arghfu/kicad-libs/3d_packages/con_fpc_20.stp

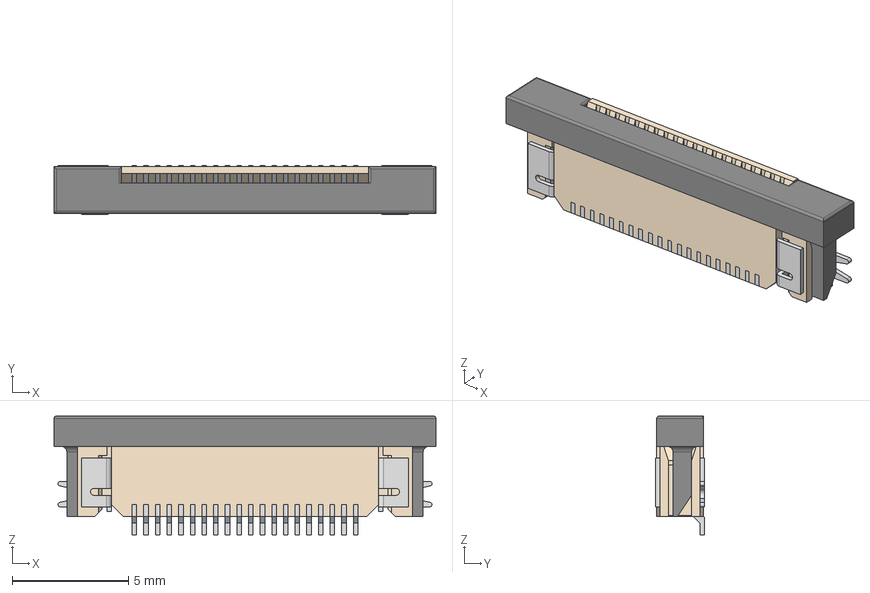
[picture p2: CAD file, 2024-05-11]
3d_packages/con_fpc_20.stp
16.4 x 2.10 x 5.10 mm
6871xx14522_PIN x 20
6871xx14522_Patte
6871xx14522_Patte_2
68712014522_CAP
