arghfu/kicad-libs/3d_packages/SW_PTS820J25MSMTRLFS.stp

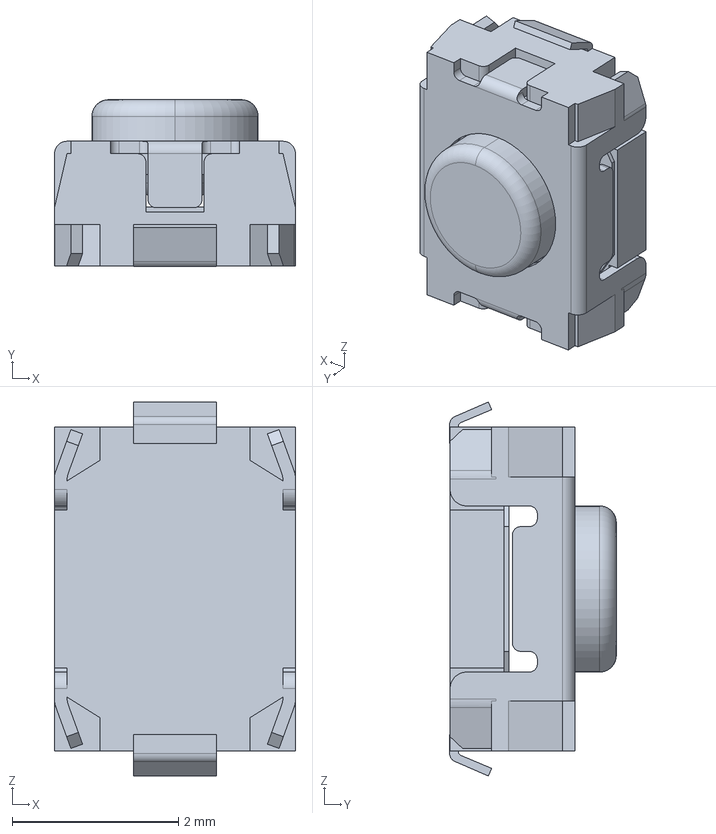
[picture p3: CAD file, 2024-05-11]
3d_packages/SW_PTS820J25MSMTRLFS.stp
2.90 x 2.00 x 4.50 mm
