arghfu/kicad-libs/3d_packages/TSM-104-01-L-DH.step

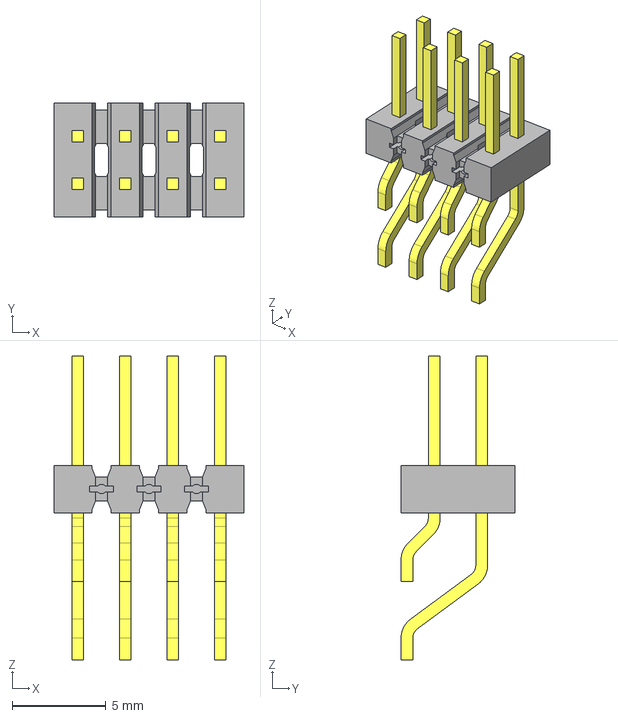
[picture p4: CAD file, 2024-05-11]
3d_packages/TSM-104-01-L-DH.step
10.2 x 6.10 x 16.3 mm
T-1S6-09(-01-4-DH)
TSM-104-01-DH_body
