arghfu/kicad-libs/3d_packages/SMI-1027-T-5V-R.step

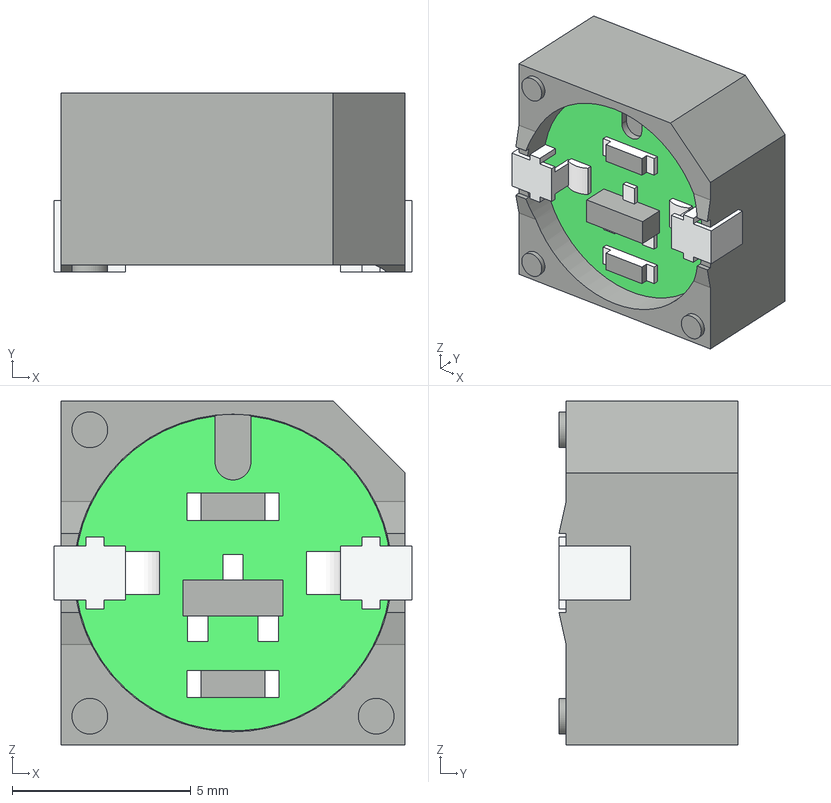
[picture p5: CAD file, 2024-05-11]
3d_packages/SMI-1027-T-5V-R.step
10.0 x 5.00 x 9.60 mm
