arghfu/kicad-libs/3d_packages/User Library-3020-20-0300-xx.STEP

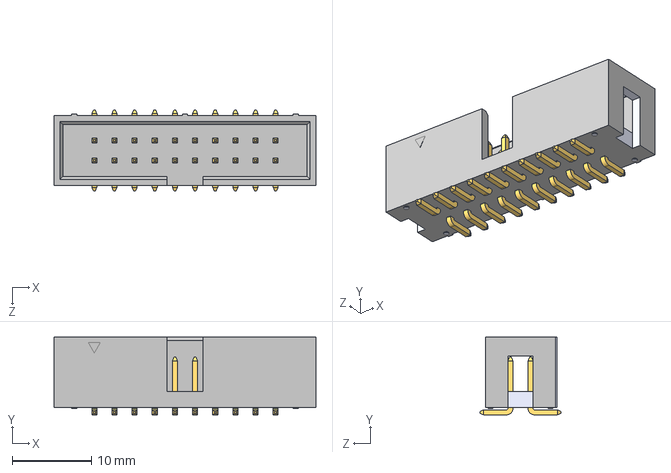
[picture p6: CAD file, 2024-05-11]
3d_packages/User Library-3020-20-0300-xx.STEP
33.0 x 9.80 x 10.2 mm
00-H
00-T-SMT
