arghfu/kicad-libs/3d_packages/NRS8040T.step

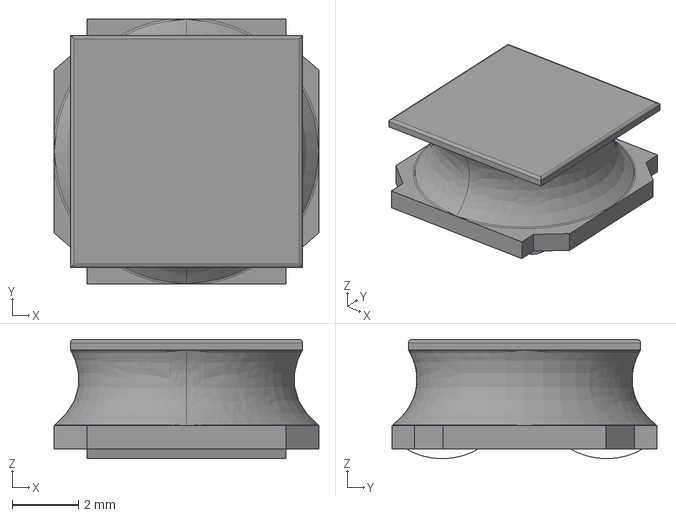
[picture p7: CAD file, 2024-05-11]
3d_packages/NRS8040T.step
8.00 x 8.00 x 3.60 mm
