arghfu/kicad-libs/3d_packages/NR4018T221M.stp

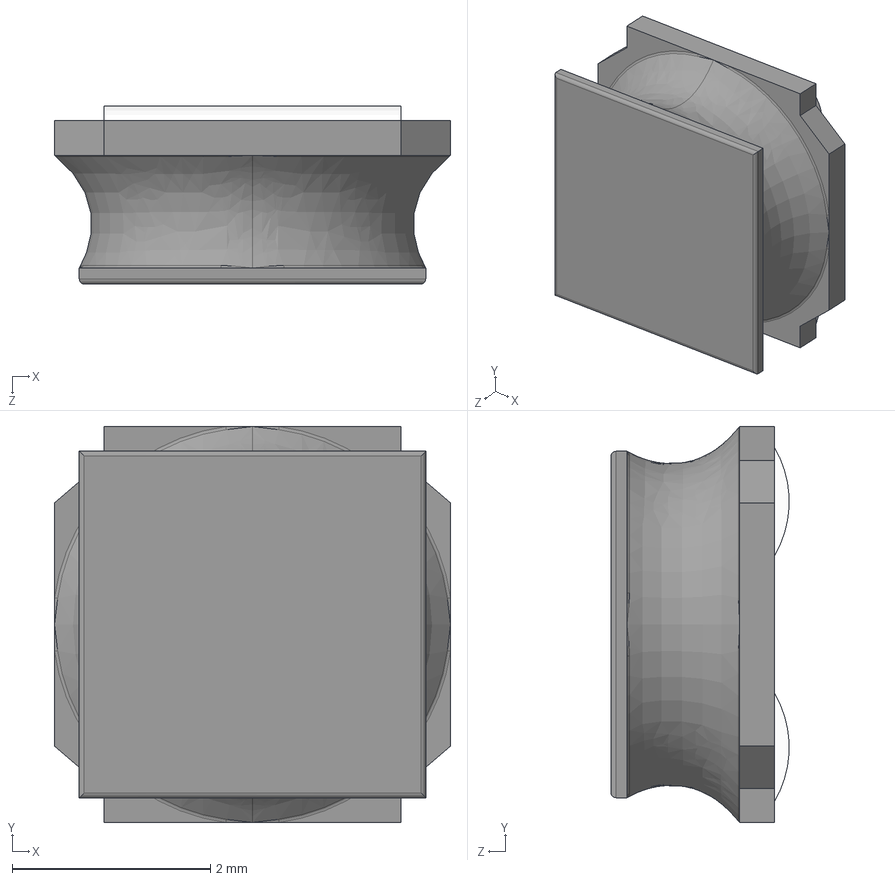
[picture p8: CAD file, 2024-05-11]
3d_packages/NR4018T221M.stp
4.00 x 4.00 x 1.80 mm
