arghfu/kicad-libs/3d_packages/PowerPAK 1212-8.STEP

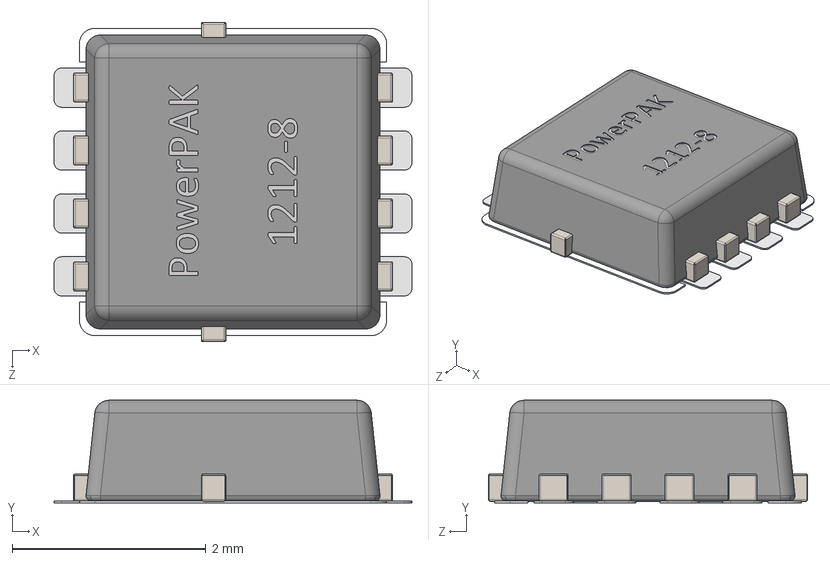
[picture p9: CAD file, 2024-05-11]
3d_packages/PowerPAK 1212-8.STEP
3.70 x 1.06 x 3.30 mm
