arghfu/kicad-libs/3d_packages/con_fpc_6.stp

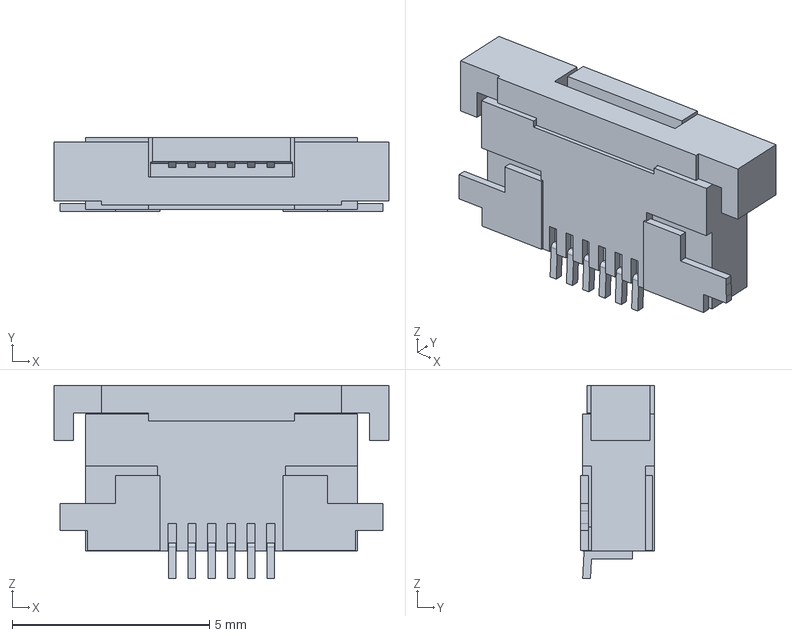
[picture p10: CAD file, 2024-05-11]
3d_packages/con_fpc_6.stp
8.50 x 1.87 x 4.90 mm
