arghfu/kicad-libs/3d_packages/flat_connector.stp

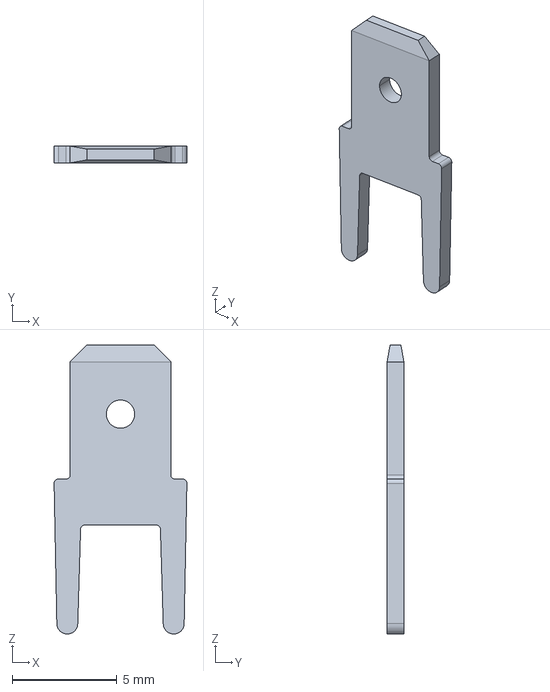
[picture p11: CAD file, 2024-05-11]
3d_packages/flat_connector.stp
6.34 x 0.8 x 13.8 mm
