arghfu/kicad-libs/3d_packages/CONMHF1-SMD-G-T.STEP

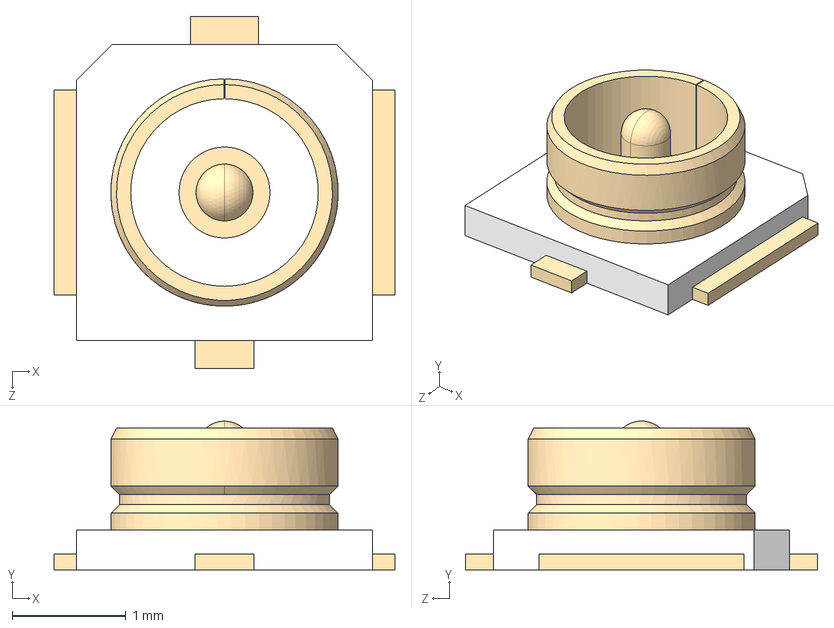
[picture p12: CAD file, 2024-05-11]
3d_packages/CONMHF1-SMD-G-T.STEP
3.00 x 1.31 x 3.10 mm
