arghfu/kicad-libs/3d_packages/Molex_Micro-Fit_3.0_43650-0715_1x07_P3.00mm_Vertical.stp

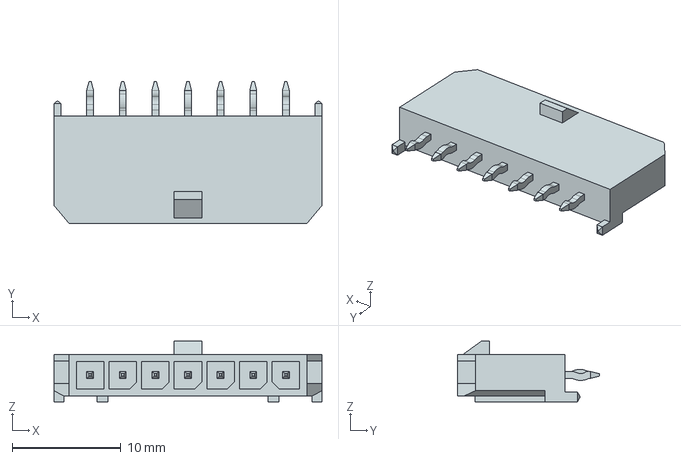
[picture p13: CAD file, 2024-05-11]
3d_packages/Molex_Micro-Fit_3.0_43650-0715_1x07_P3.00mm_Vertical.stp
24.6 x 13.1 x 5.57 mm
