arghfu/kicad-libs/3d_packages/con_fpc_31.stp

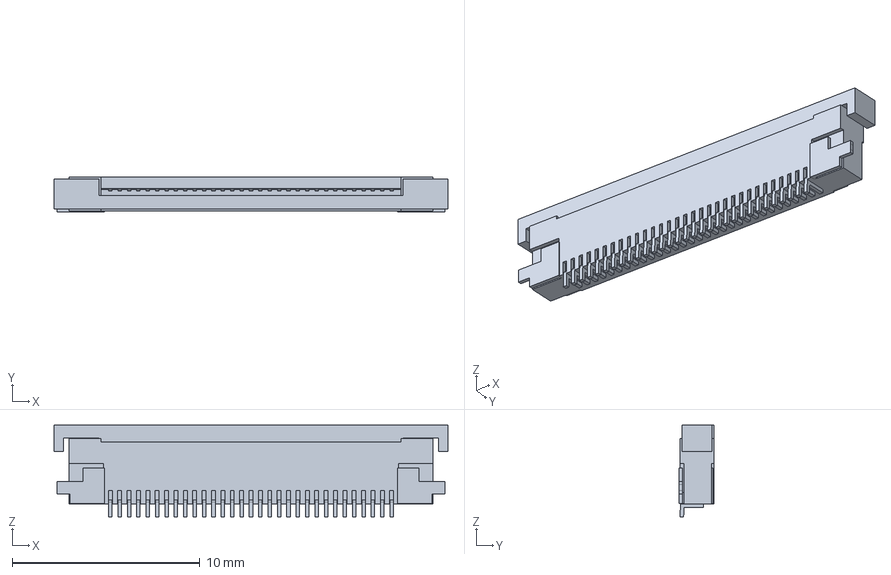
[picture p14: CAD file, 2024-05-11]
3d_packages/con_fpc_31.stp
21.0 x 1.87 x 4.90 mm
