arghfu/kicad-libs/3d_packages/WSL3637.STEP

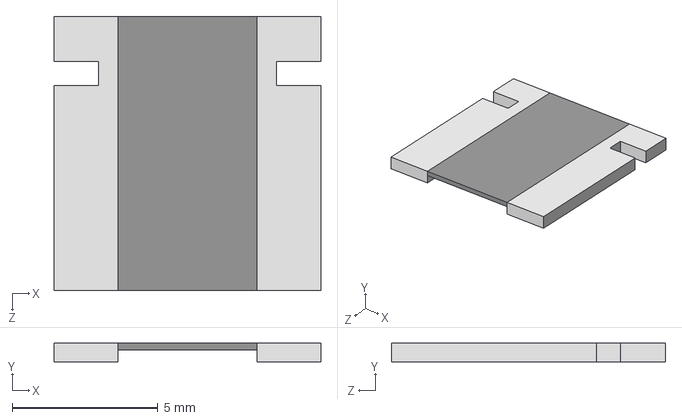
[picture p15: CAD file, 2024-05-11]
3d_packages/WSL3637.STEP
9.14 x 0.635 x 9.40 mm
