arghfu/kicad-libs/3d_packages/TestPoint_5015.STEP

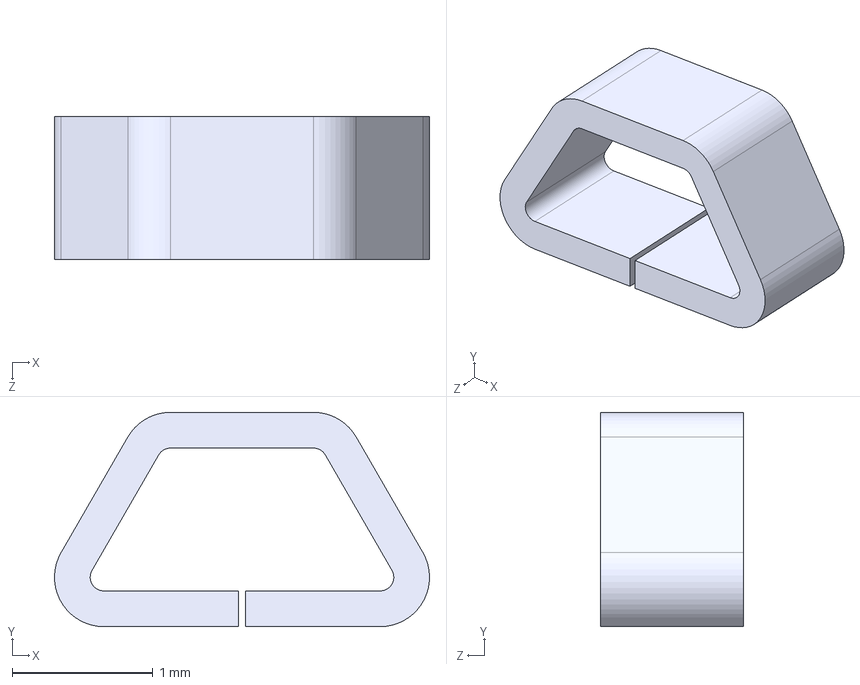
[picture p16: CAD file, 2024-05-11]
3d_packages/TestPoint_5015.STEP
2.67 x 1.52 x 1.02 mm
