arghfu/kicad-libs/3d_packages/con_usb_c_usb2-0.stp

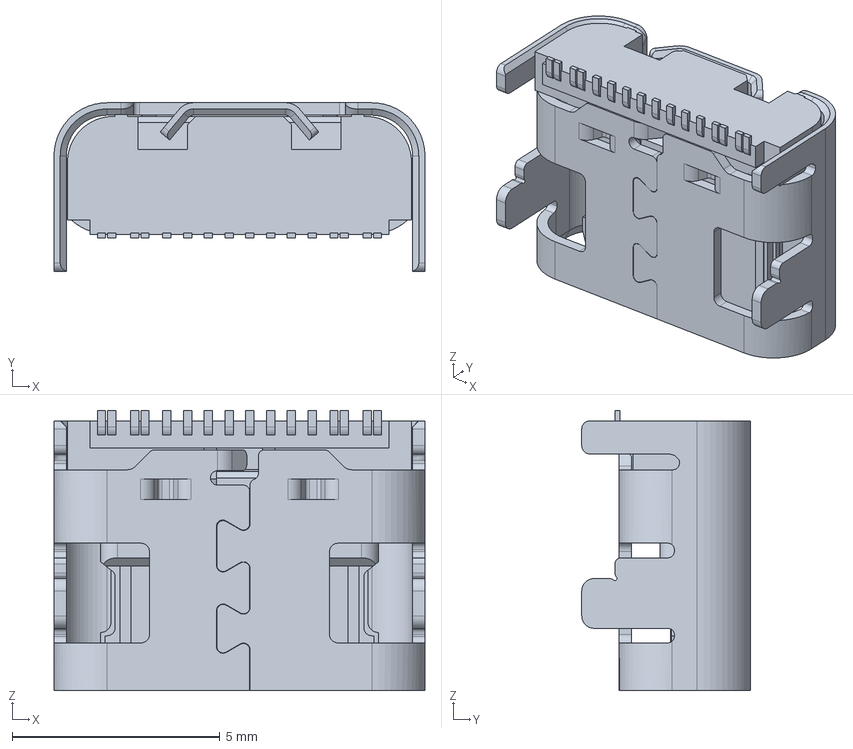
[picture p17: CAD file, 2024-05-11]
3d_packages/con_usb_c_usb2-0.stp
8.94 x 4.06 x 6.75 mm
