arghfu/kicad-libs/3d_packages/con_fpc_40.stp

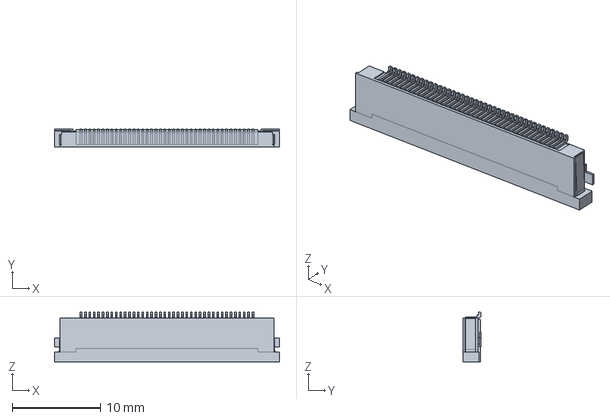
[picture p18: CAD file, 2024-05-11]
3d_packages/con_fpc_40.stp
25.5 x 2.06 x 5.64 mm
