arghfu/kicad-libs/3d_packages/NT2016SA.STEP

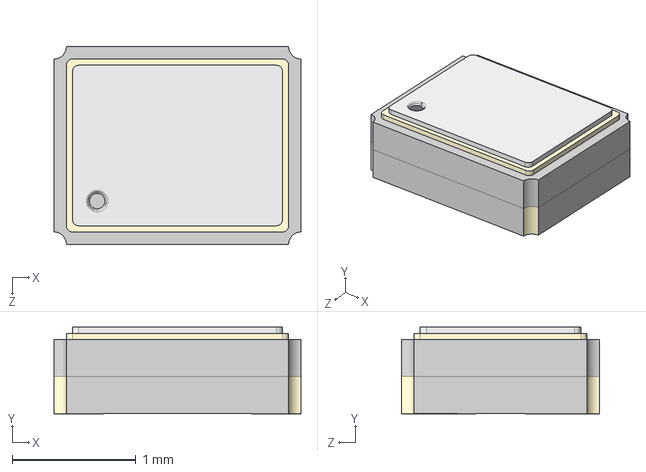
[picture p19: CAD file, 2024-05-11]
3d_packages/NT2016SA.STEP
2.00 x 0.701 x 1.60 mm
