arghfu/kicad-libs/3d_packages/TSM-106-01-L-DH.step

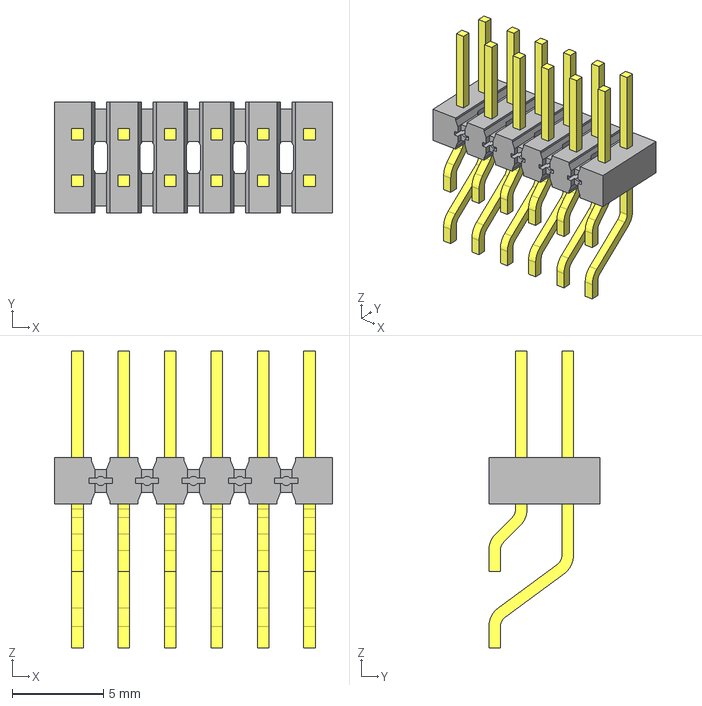
[picture p20: CAD file, 2024-05-11]
3d_packages/TSM-106-01-L-DH.step
15.2 x 6.10 x 16.3 mm
T-1S6-09(-01-6-DH)
TSM-106-01-DH_body
