arghfu/kicad-libs/3d_packages/con_2_10_1_27.igs

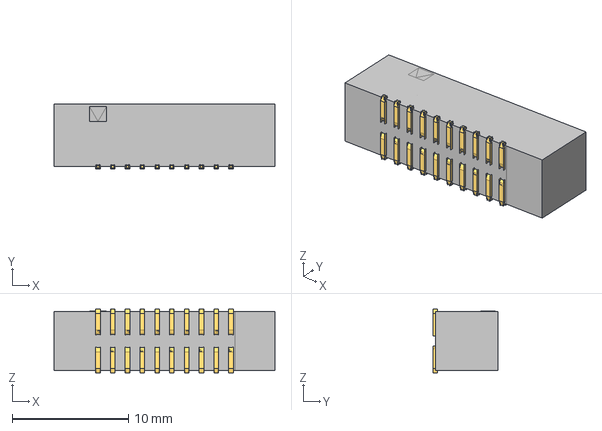
[picture p21: CAD file, 2024-05-11]
3d_packages/con_2_10_1_27.igs
19.0 x 5.60 x 5.50 mm
