arghfu/kicad-libs/3d_packages/CUI_DEVICES_MJ-2523.step

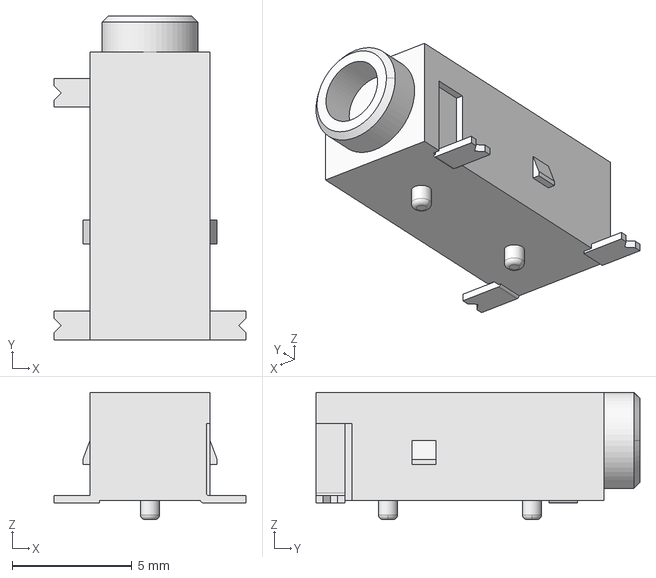
[picture p22: CAD file, 2024-05-11]
3d_packages/CUI_DEVICES_MJ-2523.step
8.00 x 13.5 x 5.30 mm
