arghfu/kicad-libs/3d_packages/SOP-4V2.STEP

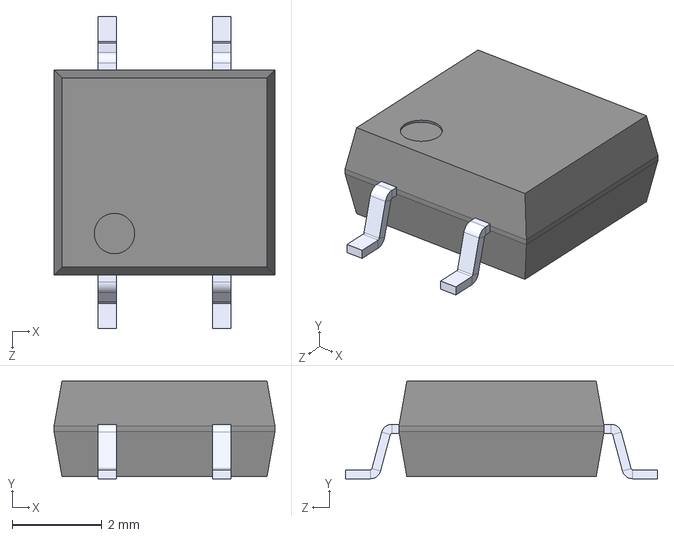
[picture p23: CAD file, 2024-05-11]
3d_packages/SOP-4V2.STEP
4.92 x 2.17 x 6.95 mm
