arghfu/kicad-libs/3d_packages/L_3012hbx.step

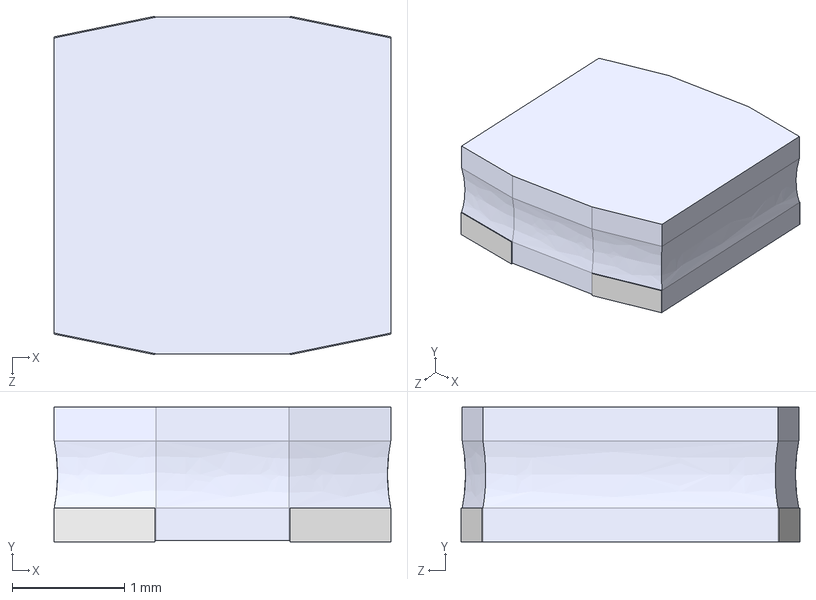
[picture p24: CAD file, 2024-05-11]
3d_packages/L_3012hbx.step
3.00 x 1.20 x 3.02 mm
