arghfu/kicad-libs/3d_packages/SW_SKRKAEE020.stp

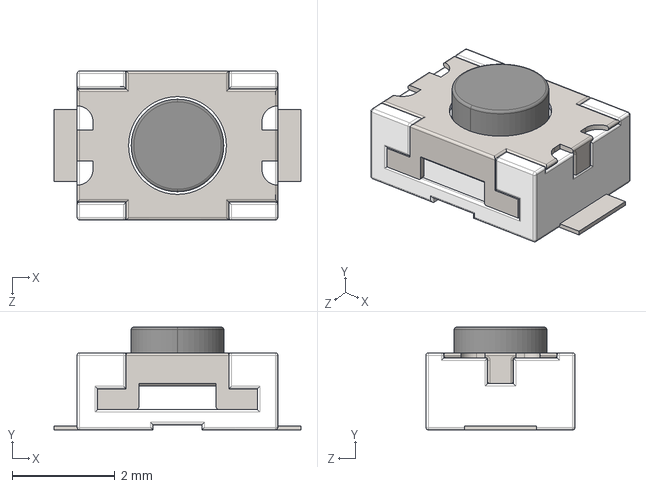
[picture p25: CAD file, 2024-05-11]
3d_packages/SW_SKRKAEE020.stp
4.80 x 2.00 x 2.90 mm
