arghfu/kicad-libs/3d_packages/BL654.STEP

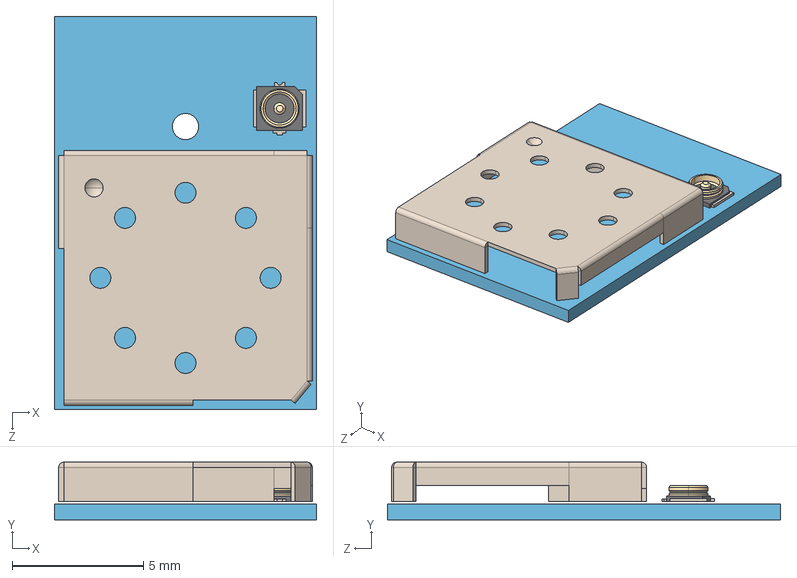
[picture p26: CAD file, 2024-05-11]
3d_packages/BL654.STEP
10.0 x 2.20 x 15.0 mm
BL654 PCB
bl654_shielding_can_20180124
BL654 Solder Pad x 72
BL652 A1 MHF4 Connector
