arghfu/kicad-libs/3d_packages/TSM-105-01-L-DH.step

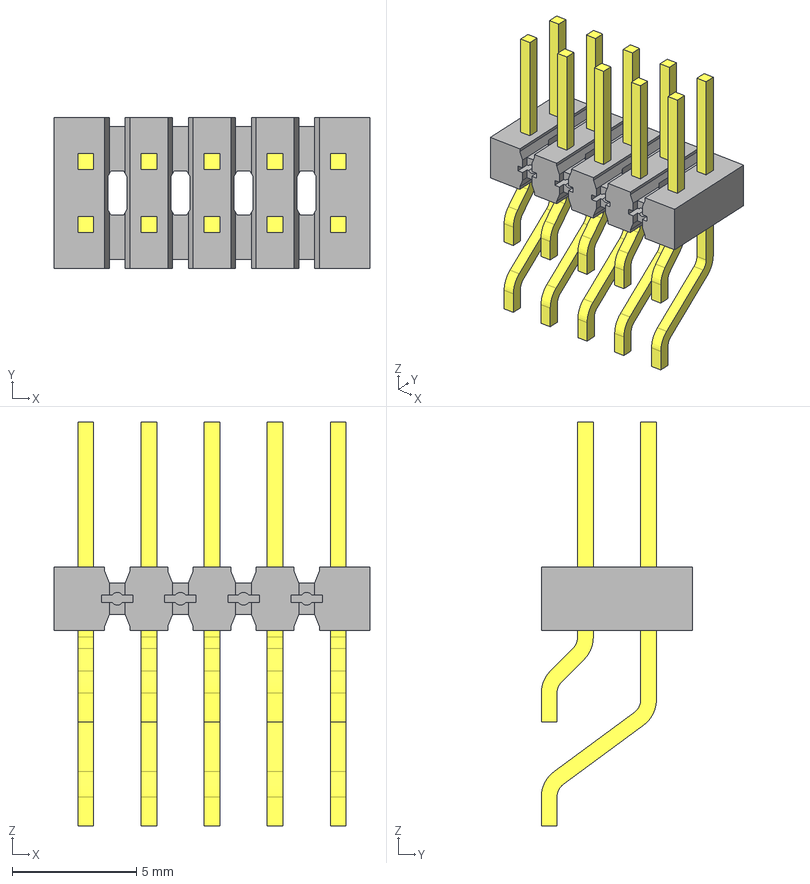
[picture p27: CAD file, 2024-05-11]
3d_packages/TSM-105-01-L-DH.step
12.7 x 6.10 x 16.3 mm
T-1S6-09(-01-5-DH)
TSM-105-01-DH_body
