arghfu/kicad-libs/3d_packages/sw_B3S.STEP

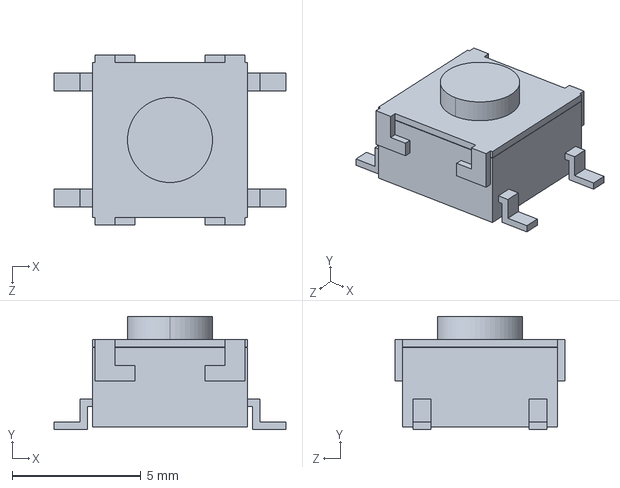
[picture p28: CAD file, 2024-05-11]
3d_packages/sw_B3S.STEP
9.00 x 4.40 x 6.60 mm
