arghfu/kicad-libs/3d_packages/con_fpc_5.stp

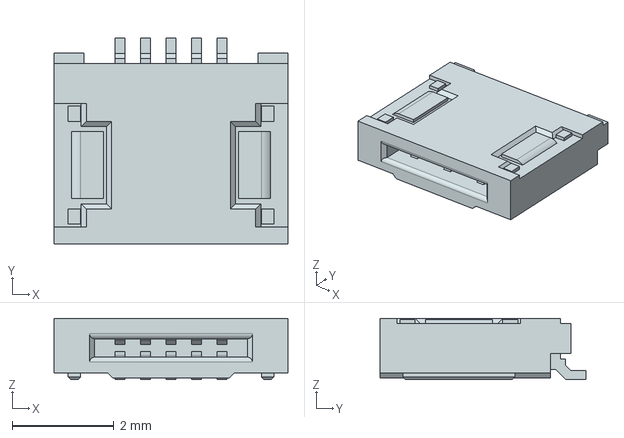
[picture p29: CAD file, 2024-05-11]
3d_packages/con_fpc_5.stp
4.60 x 4.05 x 1.20 mm
