arghfu/kicad-libs/3d_packages/con_fpc_32.STEP

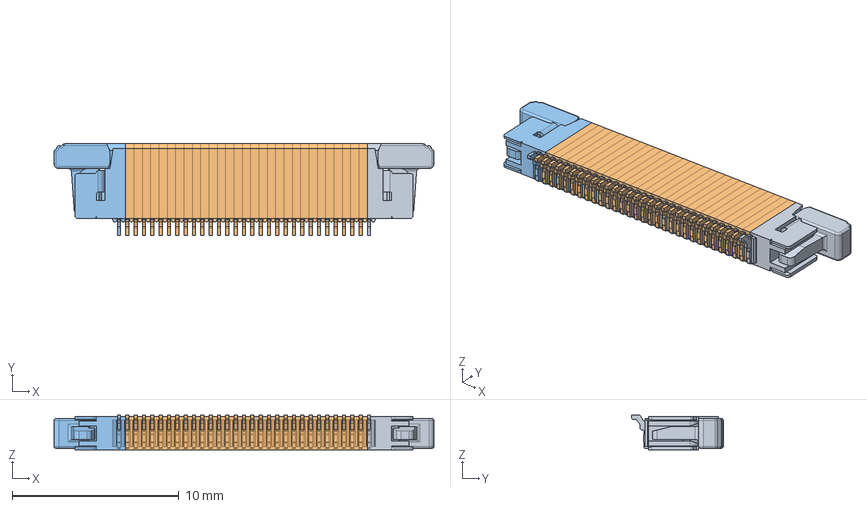
[picture p30: CAD file, 2024-05-11]
3d_packages/con_fpc_32.STEP
22.8 x 5.50 x 2.10 mm
F32R_R
F32R_M x 29
F32R_L
