arghfu/kicad-libs/(list of files, cad)

Other CAD files:
3d_packages/DPX165950DT-8048A1_TDK.step
