arghfu/kicad-libs/(commit log)

2021-12-31 migrate lib to KiCAD 6
    [CUI_DEVICES_MJ-2523-SMT-TR.step, s62684_401100alf.stp, ssfv6r_2stlf.stp]
2022-04-01 update lib
    [022057038.stp, 632723100011-Body.step, 632723100011_Download_STP_632723100011_rev1.stp, 68712014522_Download_STP_68712014522_rev1.stp, CUI_DEVICES_MJ-2523-SMT-TR-Body.step, CUI_DEVICES_MJ-2523-SMT-TR.step, ESP32-S3-WROOM.step, PTS820J25MSMTRLFS.stp]
2024-01-28 update libs
    [2023960307.stp, 2171790001.stp, 3220-20-0300.igs, 5015--3DModel-STEP-1.STEP, 512810598.stp, B3S-1000--3DModel-STEP-273799.STEP, BL654.STEP, CM8V-T1A-32.768KHZ-9PF-20PPM-TA-QC.STEP]
2024-05-11 update library
    [022057038.stp, 2023960307.stp, 2171790001.stp, 3220-20-0300.igs, 5015--3DModel-STEP-1.STEP, 512810598.stp, 632723100011-Body.step, 632723100011_Download_STP_632723100011_rev1.stp]
2024-06-17 update footprints
