arghfu/kicad-libs/(notices)

Notices in the files:
3d_packages/TSM-104-01-L-DH.step:
author */ ('License CC BY-ND 4.0'),
